joshman196/360LesPaulPCB-PinHeaderVariant/Body Side/20250310_202917.jpg

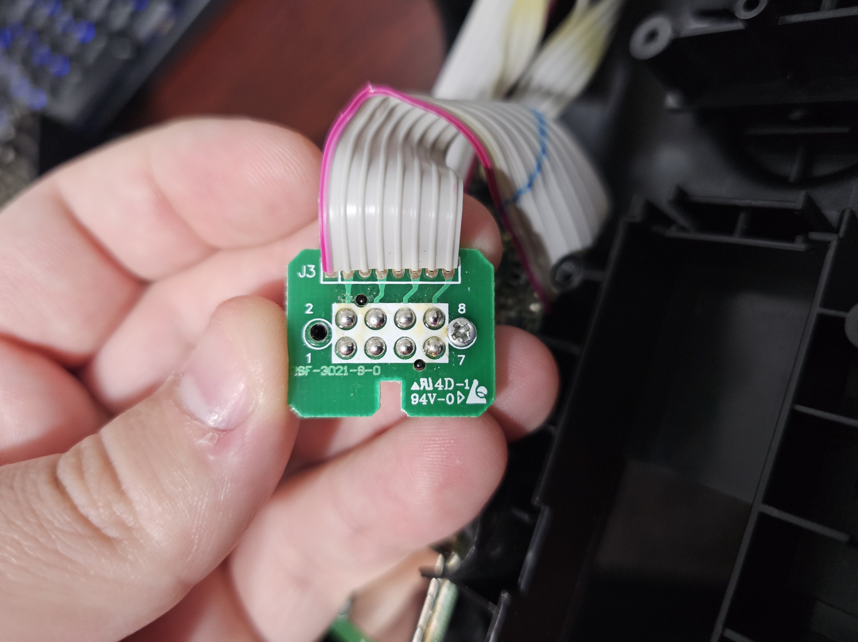
Body Side/20250310_202917.jpg
