joshman196/360LesPaulPCB-PinHeaderVariant/Body Side/20250310_202938.jpg

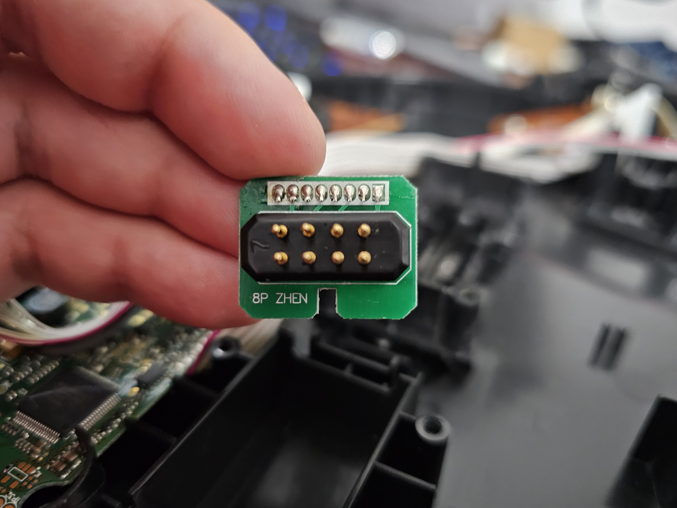
Body Side/20250310_202938.jpg
