joshman196/360LesPaulPCB-PinHeaderVariant/README.md

# Xbox 360 Les Paul Neck Connection PCBs with Pin Headers
PCBs for the Guitar Hero 3/Aerosmith Les Pauls that uses pin headers instead of the original's pogo pins. Only tested for the Xbox 360 variant.

This is meant to (hopefully) be more resilient and last longer compared to the flawed pogo pin design of the original. I have successfully been using these PCBs in my personal X360 Aerosmith Les Paul for nearly a year with no functional issues as of writing this (February 2026, PCBs were finished in March 2025). I just never published this publicly until now.

It doesn't matter which side has the male or female ends of the pin headers, but if it matters to you what I did, I put the female end on the neck side and the male end on the body side.

One thing to note is that with these new PCBs, you have to ever so slightly push harder for the spring/click to happen for the guitar neck connection. Otherwise, it works fine.

## Parts Needed
- Two 2x4 sets of pin headers—at least one male and one female—with a pitch of 2.54mm
  - You can order male headers [here](https://a.aliexpress.com/_mMtd0Sz) and female headers [here.](https://a.aliexpress.com/_mOnUzbT) **REMEMBER TO SELECT 2X4**
    - If these links die, just search up something like "2.54mm 2x4 pin headers" on aliexpress, both male and female sets
   
**REMEMBER TO SET PCB THICKNESS TO 1.2MM WHEN ORDERING**

### Body Side PCB


### Neck Side PCB

 
### Kinda bad picture but this was from when I first installed it, you get the idea
