joshman196/360LesPaulPCB-PinHeaderVariant/Body Side/360LPNeckfromBodyWithPinHeaders.kicad_sch

## KiCad design Body Side/360LPNeckfromBodyWithPinHeaders.kicad_sch (2026-02-12)

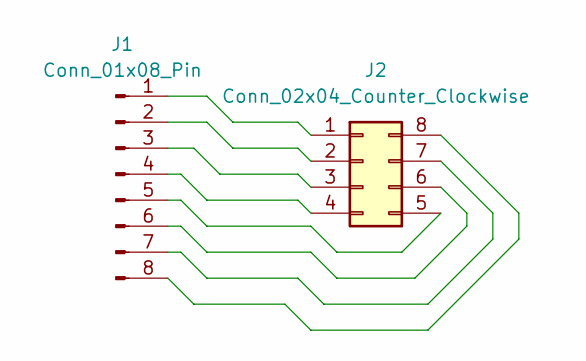
[picture p3: schematic 360LPNeckfromBodyWithPinHeaders.kicad_sch]

Parts:
J1: Conn_01x08_Pin; 1x08GHLPNeck
J2: Conn_02x04_Counter_Clockwise; PinHeader_2x04_P2.54mm_Vertical_Jank

Connections:
unnamed: J1.1, J2.1
unnamed: J1.2, J2.2
unnamed: J1.3, J2.3
unnamed: J1.4, J2.4
unnamed: J1.5, J2.5
unnamed: J1.6, J2.6
unnamed: J1.7, J2.7
unnamed: J1.8, J2.8
